Blackend7/Masterproef_2021_2022/Hardware design/Masterproef ultrasonic transducer/Masterproef ultrasonic transducer/Masterproef ultrasonic transducer top.jpg

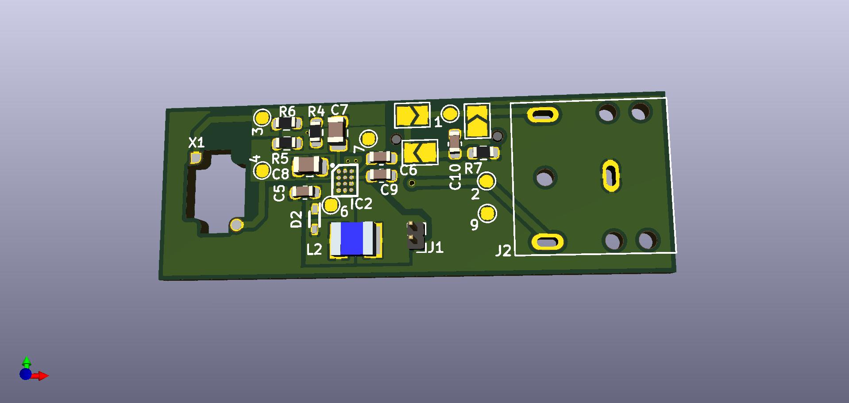
Hardware design/Masterproef ultrasonic transducer/Masterproef ultrasonic transducer/Masterproef ultrasonic transducer top.jpg
