Blackend7/Masterproef_2021_2022/Hardware design/MAsterproef verbeterd ultrasone speaker/Masterproef ultrasonic transducer.html

# C:\Users\robin\OneDrive\Masterproef 2021-2022\Hardware design\Masterproef ultrasonic transducer\Masterproef ultrasonic transducer\Masterproef ultrasonic transducer.sch

30/09/2021 14:57:56

Eeschema (5.1.10)-1

Component Count:35

Ref | Qnty | Value | Part | Footprint | Description | Vendor
C1, C4, C5, C6, C9 | 5 | 1µF | pspice:CAP | Capacitor_SMD:C_0603_1608Metric | Capacitor symbol for simulation only
C2 | 1 | 2,2µF | pspice:CAP | Capacitor_SMD:C_0603_1608Metric | Capacitor symbol for simulation only
C3, C7, C8 | 3 | 10µF | pspice:CAP | Capacitor_SMD:C_0805_2012Metric | Capacitor symbol for simulation only
D1 | 1 | NSR0520V2T1G | Masterproef-ultrasonic-transmitter-rescue:NSR0520V2T1G-SamacSys_Parts | SamacSys_Parts 2:SODFL1608X70N
IC1 | 1 | TPS61046YFFR | Masterproef-ultrasonic-transmitter-rescue:TPS61046YFFR-SamacSys_Parts | SamacSys_Parts:BGA6C40P2X3_79X119X62
IC2 | 1 | LM48580TL_NOPB | Masterproef-ultrasonic-transmitter-rescue:LM48580TL_NOPB-SamacSys_Parts | SamacSys_Parts:BGA12C50P3X4_146X196X68
J1 | 1 | Power connector | Connector_Generic:Conn_02x03_Odd_Even | Connector_PinHeader_1.00mm:PinHeader_2x03_P1.00mm_Vertical | Generic connector, double row, 02x03, odd/even pin numbering scheme (row 1 odd numbers, row 2 even numbers), script generated (kicad-library-utils/schlib/autogen/connector/)
J2 | 1 | Control | Connector:Conn_01x02_Male | Connector_PinHeader_1.00mm:PinHeader_1x02_P1.00mm_Vertical | Generic connector, single row, 01x02, script generated (kicad-library-utils/schlib/autogen/connector/)
J3 | 1 | Jack measure | Connector:Conn_01x03_Male | Connector_PinHeader_1.00mm:PinHeader_1x03_P1.00mm_Vertical | Generic connector, single row, 01x03, script generated (kicad-library-utils/schlib/autogen/connector/)
J4 | 1 | FC68131 | SamacSys_Parts_FC:FC68131 | FC68131_Farnell:CLIFF_FC68131
L1 | 1 | FDSD0420-H-100M=P3 | Masterproef-ultrasonic-transmitter-rescue:FDSD0420-H-100M=P3-SamacSys_Parts | SamacSys_Parts 2:FDSD0420WH150MP3
L2 | 1 | BRL3225T4R7M | Masterproef-ultrasonic-transmitter-rescue:BRL3225T4R7M-SamacSys_Parts | SamacSys_Parts 2:INDC3225X170N
R1 | 1 | 536k | pspice:R | Resistor_SMD:R_0603_1608Metric | Resistor symbol for simulation only
R2 | 1 | 30k | pspice:R | Resistor_SMD:R_0603_1608Metric | Resistor symbol for simulation only
R3, R4 | 2 | 100k | pspice:R | Resistor_SMD:R_0603_1608Metric | Resistor symbol for simulation only
R5 | 1 | 10 | pspice:R | Resistor_SMD:R_0603_1608Metric | Resistor symbol for simulation only
R6 | 1 | 1 | pspice:R | Resistor_SMD:R_0603_1608Metric | Resistor symbol for simulation only
X1 | 1 | Adap_UT_P2019 | Masterproef-ultrasonic-transmitter-rescue:Adap_UT_P2019-SamacSys_Parts | SamacSys_Parts:Adap_UT_P2019
