Blackend7/Masterproef_2021_2022/lectuur dramco/Lectuur/Overview of Ultrasonic or Combined Positioning Systems.docx

# Overview of Ultrasonic or Combined Positioning Systems

## Small band Ultrasonic

### The Cricket Indoor Location System (N. B. Priyantha, H. Balakrishnan)

There are two types of entities in the system:

- Beacons: they have a fixed position and send out periodically RF signals with an embedded ID code, temperature and coordinates. Together with this, an US signal is transmitted.

-Listeners: calculate their relative position based on the distances to the nearest beacons

Distance measurements are calculated by measuring the TDOA between RF and US.
The US signal is sent at the start of the RF message, and not at the start of the RF Signal.
Coverage is small: for a room size of 10x10x10m, 70 beacons are necessary

Cricket accuracy is around the 10cm for distances up to 6m.

The accuracy of the system heavily depends on:

- Line Of Sight
- The availability of the US signal: this is threshold based.
- Timing quantization, which is limited (1 µs)

### Error Compensation for Cricket Indoor Location System (S. Zhou, H. Feng, R. Yuan)

The accuracy of the cricket system is improved by compensating the error introduced by US fading. This is done both for the increasing distance, as well as the increasing orientation angle.
The average value of the absolute error is reduced to 5.6 cm and the standard deviation of the absolute error is reduced to 3.99cm.

### The research on Indoor Location System Based on Cricket (H. Wang, Y. Wang)

Badly written paper.
Use some kind of polling system to avoid collisions.

### Active Bat A. Harter, A. Hopper, P. Steggles, A. Ward, P. Webster

Consists of a wired receiver matrix mounted on the ceiling, which are connected to a PC.

Wireless transmitters have an unique ID and consist of a RF transceiver and an US transmitter
Positioning is done as followed: the RF base stations (receiver matrix) send out a RF signal on which the correct bat answers with a US pulse. The receivers then calculate the position of the bat.
It has 7cm accuracy, is strongly centralized and needs precisely positioned receiver nodes.

### Dolphin: A Practical Approach for Implementing a Fully Distributed Indoor Ultrasonic Positioning System M. Minami, Y. Fukuju, K. Hirasawa, S. Yokoyama, M. Mizumachi, H. Morikawa, T. Aoyama

The problem with Active Bat and Cricket is that they need a lot of reference nodes that are exactly positioned.

Dolphin system uses Iterative multilateration. Every node in iterative multilateration that can estimate its own position becomes a reference (anchor) node itself.

Valid distances are limited to 3m, limited to 50 nodes due to processing time and propagation speed US. Precision is limited to 10-20 cm.

### Hexamite www.hexamite.com

Claim an accuracy of 3mm.
No technical information available: what does it use? US + RF?

### Indoor Positioning using Ultrasonic Waves with CSS and FSK Modulation for Narrow Band Channel A. Ens, F. Hoeflinger, L. Reindl, J. Wendeberg and C. Schindelhauer

Make use of chirps for:

1) Synchronisation
2) Communication

This is done via Chirp Spread Spectrum and Frequency shift keying.

Chirp up or high frequency is 1, chirp down or lower frequency is 0.

No practical results.

### Ultrasonic Autonomous Robot Localization System. L. Kleeman

System in which the fixed nodes are known.

Uses chirps with a fixed duration.
The time difference between the incoming chirps give an indication of the distance between the different beacons.

### The BUZZ: Narrowband ultrasonic positioning for wearable computers. M. R. McCarthy

Positioning is done at the hand of patterns, with the timing information communicated from the infrastructure to the wearable device.
There is no RF signal, only a US.

There are two types of the buzz:

Synchronous: transmitters are synchronized throughout a cable

Asynchronous: like cricket, without the RF. Low accuracy.

The mobile needs to be at the specific place when started.

4cm accuracy @ 50% of the cases, 10cm @ 95% of the cases.

### Low-Power Simplex Ultrasound Communication For Indoor Localization A. Ens, L. Reindl, T. Janson, C. Schindelhauer.

## Ultrasonic TDOA technique that uses Pi/4 DQPSK (this uses a PI/4 phase transmission between 2 recursive signals). Distance up to 20m, with a theoretical error of 3,7 µm.

TDOA is generated thanks to a fixed interval between two recursive signals. Different transmitters have different intervals.
They don’t care about collisions and use LOS only.

The PI/4 is generated throughout tables in the microcontroller.
Localization is calculated on a different server.

### A battery-free RFID-based indoor acoustic localization platform Y. Zhao, J.R. Smith

Uses a combination of RF and US to localize a passive tag. It consist of 3 parts: programmable UHF tags (WISP) for the receiver (Rx) and transmitting end (Tx), and an off-the-shelf RFID reader.

Distance measurements:

1. RFID reader sends out Query’s to detect possible Rx. The Rx answers with a 16-bit know number (RN16: which is normally random). Normally, every tag answers, but the Tx tags are configured to only monitor the nearby RF field.
2. RFID reader answers with an ACK and the RN16 number.
3. Rx will send its own EPC code (unique ID).
4. Upon reception of the ACK and after finishing the Rx’s EPC transmission, the receiver starts a timer and the transmitters send out a US signal, this with fixed interval between two US signals coming from different Tx.
5. The ToA of the received US signals are stored on the Rx and the next round they are backscattered to the RFID reader.
6. At the RFID-reader: the location is calculated with trilateration.

Distances are limited to 3m due to detection timeouts coming from energy constraints.
Accuracy is 0 to 1.5cm within the testing range of 0.6 to 2.2m.

Transmitters are placed on known positions.

Power usage: the Rx only uses 82 µW which is harvested from RF-energy.

### Ultrasound Indoor Positioning system Based on Low-Power Wireless Sensor Network Providing Sub-Centimeter Accuracy C. Medina, J. C. Segura, A. De La Torre

This paper describes the TELIAMADe system.

This system uses a master-slave topology in which the master node is connected to a PC to do the calculations (acts as a gateway). The communication, synchronization, configuration and control between the master and the slaves is done throughout Zigbee. Time synchronisation is done with periodic Zigbee messages.

Nodes are equipped with a pair of ceramic US piezotransducers (1 for Tx, 1 for Rx) Synchronisation in the ultrasonic channel is done by using TDMA.

TOF measurements are returned over Zigbee.

Power consumption is 29.9 mA in active mode, 1,7 mA in inactive mode.

To improve distance measurements, quadrature sampling is used.

Root Mean Square Error is lower than 2mm

## Broadband Ultrasonic

### Why?

Smallband US:

- single user access
- Slower data rate
- Noise Sensitive

### Broadband US Location Systems for Improved Indoor Position (M. Hazas, A. Hopper)

Made their own piezofilm transceiver: improved BW (76 kHz, 2,5m distance).
Used DSSS (Direct Sequence Spread Spectrum) which uses pseudo random codes to spread out the signal over the spectrum. (Gold codes in this case)
CDMA: Code Division Multiple Access: preventing the overlap of signals that are coming from different users.
They give mm accuracy for distances up to 2,5m.
No information about the power usage.
To improve signal detection and prevent interference between different users in the CDMA they make use of SIC (Successive Interference Cancellation).

### High Precision OFDM-based multiple Ultrasonic transducers (O. Khyam, J. Alam, A. J. Lambert, M. A. Garratt, M. P. Pickering)

Overview of different US positioning systems.
Uses OFDM (Orthogonal Frequency Division Multiplexing) in which the available US spectrum is divided into several, small band channels (sub carriers).
Sub mm accuracy in a small 3D environment (20x20x20 mm)

### Opto-Acoustic Distance Measurement Using Spread Spectrum Techniques and Carrier Phase Measurements P. Rapp, O. Sawodny, C. Tarin.

Uses Ultrasonic and Infrared to determine distances. With a fixed receiver and a mobile transmitter.
This is done via 2 techniques:

- Envelope Time of Flight (cm accuracy). This uses Gold Codes to define the ID of the transmitter. This enable CDMA. The distances are calculated via a convolution between the Received IR and Received Ultrasonic signal.
- Carrier Phase mode: (mm accuracy) which uses zero-crossing to know the phase difference between the received US and IR signal.

### Ultrasonic Multiple-Access Ranging System Using Spread Spectrum and MEMS Technology for Indoor Localization L. Segers, J. Tiete, A. Braeken, A. Touhafi.

Spread Spectrum via:

- DSSS and gold codes. The spreading is done throughout Binary Phase Shift Keying around 40k.
- FHSS: frequency hopping spread spectrum. In which gold codes are used by switching between 4 frequencies.

Distance measurements have sub-cm accuracy with 1 node and 5 cm when 2 nodes are transmitting at the same time.

Synchronisation is done with a fixed link between sender and receiver.

### High-Accuracy Reference-Free Ultrasonic Location Estimation M. M. Saad, C. J. Bleakley, T. Ballal, S. Dobson

Reference free = no timing reference signal is used (RF, IR, …)
Beacons send out a unique FHSS (Frequency Hopping Spread Spectrum) signal with Gold, m-sequence, Kasami or Golay code as a hopping sequence SS code.
Beacons are completely independent and share no timing reference information.

Receiver must consist of at least 3 microphones in a triangle.

The algorithm utilizes an AoA-based location method to obtain an initial estimate of its own location. Based on this, it estimates the timing offsets between the MD clock and the beacon transmission. The average and the known periodicities of the beacon signals are then used to obtain a second more accurate MD location estimate via TOF.

9.5 cm accuracy in 99% cases.

### Highly Accurate TOF Measurement Technique Based on Phase-Correlation for Ultrasonic Ranging O. Khyam, S. S. Ge, X. Li, M. R. Pickering

Improved cross correlation technique is proposed for signals with the same bandwidth.
This technique uses phase correlation instead of cross correlation in time which results in a much smaller correlation peak and thus a more accurate measurements.

Precision is 0,1 till 9.17mm

A system model for linear chirp is introduced.

### Subcentimeter-Accuracy Localization through broadband acoustic transducers. J. C. Prieto, A. R. Jimenez, J. I. Guevara, J. L. Ealo, F. A. Seco, J. O. Roa, F. X. Ramos

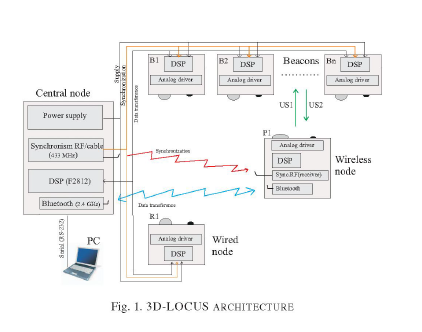
[picture p3: figure]

3D-LOCUS homogeneous network of wired and wireless sensor nodes governed by a central node. PC connected to the central node is used for high-level data processing and analysis.

Wired connections are done via a BusCAN network for data and a LVDS bus for synchronization.
Wireless connections are done with Bluetooth for data and a standard 433 MHz radio link for synchronisation.

Wideband acoustic transmitters with BW from 5kHz to 25 kHz.

Golay codes are used for cross correlation because of their more efficient computation than standard FFT’s.

2.8x2.8m cell with robotic arm to move the node. In ideal conditions the accuracy was 0.22mm.
