Blackend7/Masterproef_2021_2022/Bronnen - literatuur studie/Gebruikte lectuur/bronnen voor wifi.docx

### Wireless Indoor Localization: A Crowdsourcing Approach by Chenshu Wu, Zheng Yang, Yunhao Liu. (https://limo.libis.be/primo-explore/fulldisplay?docid=32LIBIS_ALMA_DS71222208870001471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)

Wu, Chenshu.; Wu, Chenshu. [author] () ; Yang, Zheng. [author.] ; Liu, Yunhao.

Singapore : Springer Singapore : Imprint Springer, 2018.

https://limo.libis.be/primo-explore/fulldisplay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,contains,Wifi,AND&query=title,contains,%22indoor%20localization%22,AND&mode=advanced&offset=0

(https://limo.libis.be/primo-explore/fulldisplay?docid=TN_cdi_webofscience_primary_000448661500265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)

Artikel

### A High Accuracy Time-Reversal Based WiFi Indoor Localization Approach with a Single Antenna (https://limo.libis.be/primo-explore/fulldisplay?docid=TN_cdi_webofscience_primary_000448661500265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)

Zheng, Lili ; Hu, Binjie ; Chen, Haoxiang

BASEL: MDPI

Sensors (Basel, Switzerland), 2018-10-12, Vol.18 (10), p.3437

https://limo.libis.be/primo-explore/fulldisplay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,contains,Wifi,AND&query=title,contains,%22indoor%20localization%22,AND&query=title,contains,Time,AND&mode=advanced&offset=0

Conferentieverslag

### An Accurate AoA Estimation Approach for Indoor Localization Using Commodity Wi-Fi Devices (https://limo.libis.be/primo-explore/fulldisplay?docid=TN_cdi_ieee_primary_8567806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)

Chen, Hao-Xiang ; Hu, Bin-Jie ; Zheng, Li-Li ; Wei, Zong-Heng

IEEE

2018 IEEE International Conference on Signal Processing, Communications and Computing (ICSPCC), 2018-09, p.1-5

https://limo.libis.be/primo-explore/fulldisplay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,contains,Wifi,AND&query=title,contains,%22indoor%20localization%22,AND&query=title,contains,AOA,AND&mode=advanced&offset=0

Due to the ubiquity of Wi-Fi infrastructure, Wi-Fi-based

indoor localization technology is the mainstream solution to

the above problem in academic. At present, most of the Wi-

Fi-based solutions are using fingerprinting approaches [2-5],

which will be easy to implemented. When the fingerprint

database is constructed in off-line stage, they can achieve

meter-level localization accuracy in on-line stage. As is

known to all, the disadvantage of fingerprinting-based

approaches is that the fingerprint database construction takes

a lot of time and resources. Moreover, when the environment

changes, we need to reconstruct the fingerprint database,

otherwise the performance of localization will be deteriorated

significantly.

Comparing with fingerprinting-based approaches, Angleof-

Arrival (AoA) based approaches have attracted widely

attention due to their zero start-up costs. Recently, multiantenna

has been deployed in the commodity Wi-Fi

infrastructure, which allows us to perform AoA-based indoor

localization approaches via Wi-Fi.
