Blackend7/Masterproef_2021_2022/Deeltaken/varia/Binnenshuis lokalisatie tussentijdse planning.docx

# Binnenshuis lokalisatie

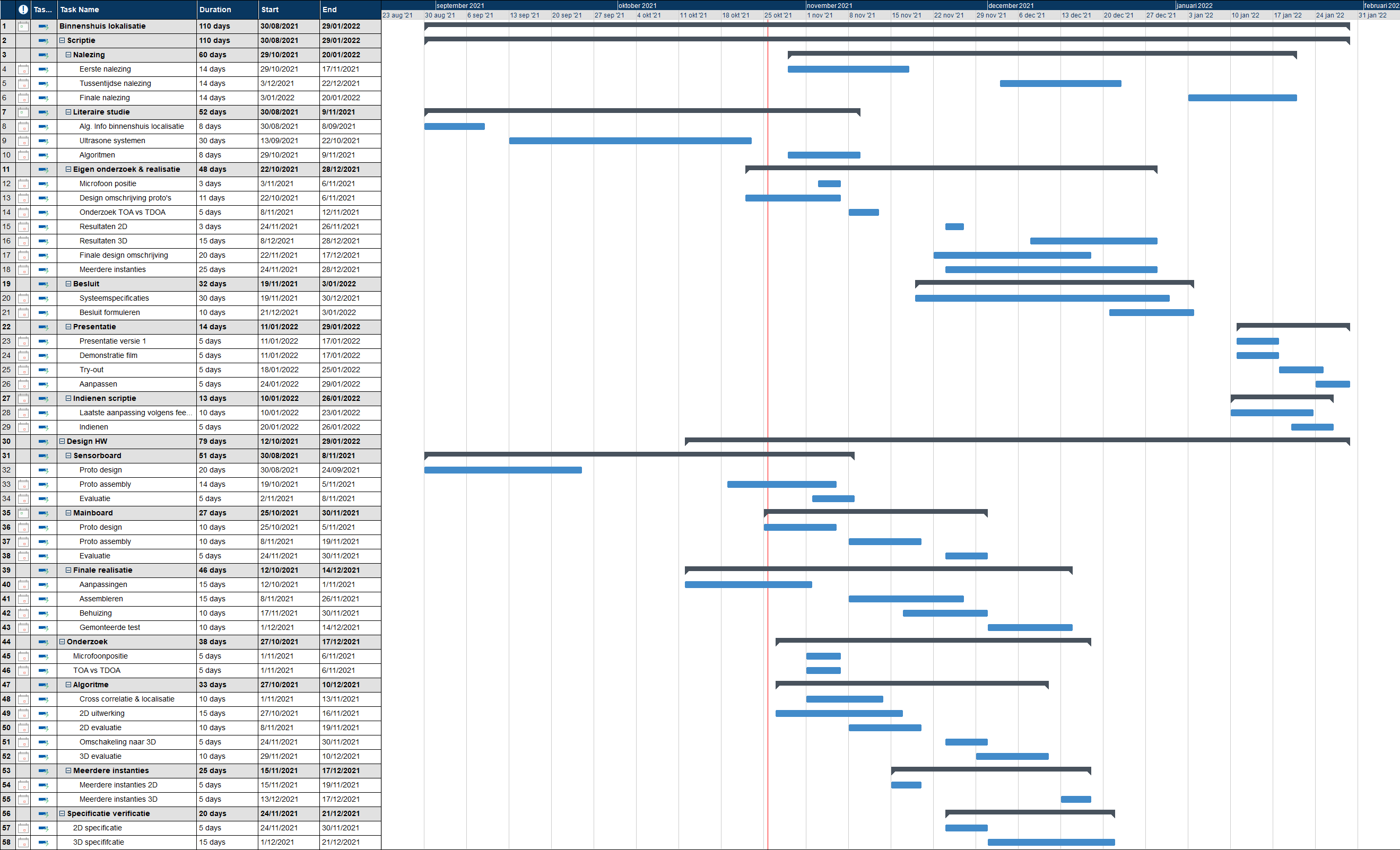
[picture p4: figure]
MindMap Preview

# 1 Scriptie

## 1.1 Nalezing

### Eerste nalezing

### Tussentijdse nalezing

### Finale nalezing

## 1.2 Literaire studie

### Alg. Info binnenshuis localisatie

### Ultrasone systemen

### Algoritmen

## 1.3 Eigen onderzoek & realisatie

### Microfoon positie

### Design omschrijving proto's

### Onderzoek TOA vs TDOA

### Resultaten 2D

### Resultaten 3D

### Finale design omschrijving

### Meerdere instanties

## 1.4 Besluit

### Systeemspecificaties

### Besluit formuleren

## 1.5 Presentatie

### Presentatie versie 1

### Demonstratie film

### Try-out

### Aanpassen

## 1.6 Indienen scriptie

### Laatste aanpassing volgens feedback

### Indienen

# 2 Design HW

## 2.1 Sensorboard

### Proto design

### Proto assembly

### Evaluatie

## 2.2 Mainboard

### Proto design

### Proto assembly

### Evaluatie

## 2.3 Finale realisatie

### Aanpassingen

### Assembleren

### Behuizing

### Gemonteerde test

# 3 Onderzoek

## 3.1 Microfoonpositie

## 3.2 TOA vs TDOA

## 3.3 Algoritme

### Cross correlatie & localisatie

### 2D uitwerking

### 2D evaluatie

### Omschakeling naar 3D

### 3D evaluatie

## 3.4 Meerdere instanties

### Meerdere instanties 2D

### Meerdere instanties 3D

# 4 Specificatie verificatie

## 4.1 2D specificatie

## 4.2 3D specififcatie

[Title] | February 17, 2015
