Blackend7/Masterproef_2021_2022/Hardware design/Masterproef ultrasonic transducer/BOM ultrasonic transducer Robin Van de Poel met supplier.xlsx

 |  |  | Digi-key | Farnell
Component Count: | 25
Ref | Value | Footprint
C1 | 1µF | Capacitor_SMD:C_0603_1608Metric | https://www.digikey.be/product-detail/en/taiyo-yuden/TMK107BJ105KA8T/587-TMK107BJ105KA8TTR-ND/14311221
C2 | 2,2µF | Capacitor_SMD:C_0603_1608Metric | https://www.digikey.be/product-detail/en/taiyo-yuden/TMK107ABJ225KA-T/587-2909-1-ND/2649029
C3 | 10µF | Capacitor_SMD:C_0805_2012Metric | https://www.digikey.be/product-detail/en/taiyo-yuden/LMK212BJ106KD-T/587-1299-1-ND/931076
C4 | 1µF | Capacitor_SMD:C_0603_1608Metric | https://www.digikey.be/product-detail/en/taiyo-yuden/TMK107BJ105KA8T/587-TMK107BJ105KA8TTR-ND/14311221
C5 | 1µF | Capacitor_SMD:C_0603_1608Metric | https://www.digikey.be/product-detail/en/taiyo-yuden/TMK107BJ105KA8T/587-TMK107BJ105KA8TTR-ND/14311221
C6 | 1µF | Capacitor_SMD:C_0603_1608Metric | https://www.digikey.be/product-detail/en/taiyo-yuden/TMK107BJ105KA8T/587-TMK107BJ105KA8TTR-ND/14311221
C7 | 10µF | Capacitor_SMD:C_0805_2012Metric | https://www.digikey.be/product-detail/en/samsung-electro-mechanics/CL21A106KAYNNNG/1276-6454-1-ND/5958082
C8 | 10µF | Capacitor_SMD:C_0805_2012Metric | https://www.digikey.be/product-detail/en/samsung-electro-mechanics/CL21A106KAYNNNG/1276-6454-1-ND/5958082
C9 | 1µF | Capacitor_SMD:C_0603_1608Metric | https://www.digikey.be/product-detail/en/taiyo-yuden/TMK107BJ105KA8T/587-TMK107BJ105KA8TTR-ND/14311221
D1 | NSR0520V2T1G | SamacSys_Parts 2:SODFL1608X70N
IC1 | TPS61046YFFR | SamacSys_Parts:BGA6C40P2X3_79X119X62
IC2 | LM48580TL_NOPB | SamacSys_Parts:BGA12C50P3X4_146X196X68 | https://www.digikey.be/product-detail/en/texas-instruments/LM48580TLX-NOPB/LM48580TLX-NOPBCT-ND/2346535
J1 | Power connector | Connector_PinHeader_1.00mm:PinHeader_2x03_P1.00mm_Vertical
J2 | Control | Connector_PinHeader_1.00mm:PinHeader_1x02_P1.00mm_Vertical
J3 | Jack measure | Connector_PinHeader_1.00mm:PinHeader_1x03_P1.00mm_Vertical
J4 | FC68131 | FC68131_Farnell:CLIFF_FC68131 |  | https://be.farnell.com/cliff-electronic-components/fc68131/stereo-jack-3-5mm-3pos-pcb/dp/2518188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
L1 | FDSD0420-H-100M=P3 | SamacSys_Parts 2:FDSD0420WH150MP3 |  | https://be.farnell.com/murata/fdsd0420-h-100m-p3/inductor-10uh-2a-20-shielded/dp/2530093?CMP=GRHB-SF-BNL
L2 | BRL3225T4R7M | SamacSys_Parts 2:INDC3225X170N | https://www.digikey.be/product-detail/en/taiyo-yuden/BRL3225T4R7M/587-2166-1-ND/2002864 | https://be.farnell.com/taiyo-yuden/brl3225t4r7m/wirewound-inductor-4-7uh-1-3a/dp/1839395?st=brl3225t4r7m
R1 | 536k | Resistor_SMD:R_0603_1608Metric | https://www.digikey.be/product-detail/en/stackpole-electronics-inc/RMCF0603FT536K/RMCF0603FT536KCT-ND/2418087
R2 | 30k | Resistor_SMD:R_0603_1608Metric | https://www.digikey.be/product-detail/en/panasonic-electronic-components/ERJ-PB3B3002V/P20138CT-ND/6214393
R3 | 100k | Resistor_SMD:R_0603_1608Metric | https://www.digikey.be/product-detail/en/panasonic-electronic-components/ERA-3ARB104V/P100KBDCT-ND/3073246
R4 | 100k | Resistor_SMD:R_0603_1608Metric | https://www.digikey.be/product-detail/en/panasonic-electronic-components/ERA-3ARB104V/P100KBDCT-ND/3073246
R5 | 10 | Resistor_SMD:R_0603_1608Metric | https://www.digikey.be/product-detail/en/stackpole-electronics-inc/RNCF0603AKT10R0/RNCF0603AKT10R0CT-ND/4928393
R6 | 1 | Resistor_SMD:R_0603_1608Metric | https://www.digikey.be/product-detail/en/panasonic-electronic-components/ERJ-3RQF1R0V/P1-0AJCT-ND/308110
X1 | Adap_UT_P2019 | SamacSys_Parts:Adap_UT_P2019 | https://www.digikey.be/product-detail/en/usound-gmbh/UT-P2019/2000-UT-P2019-ND/12658981
