Blackend7/Masterproef_2021_2022/Hardware design/BRL3225T4R7M/3D/BRL3225T4R7M.stp

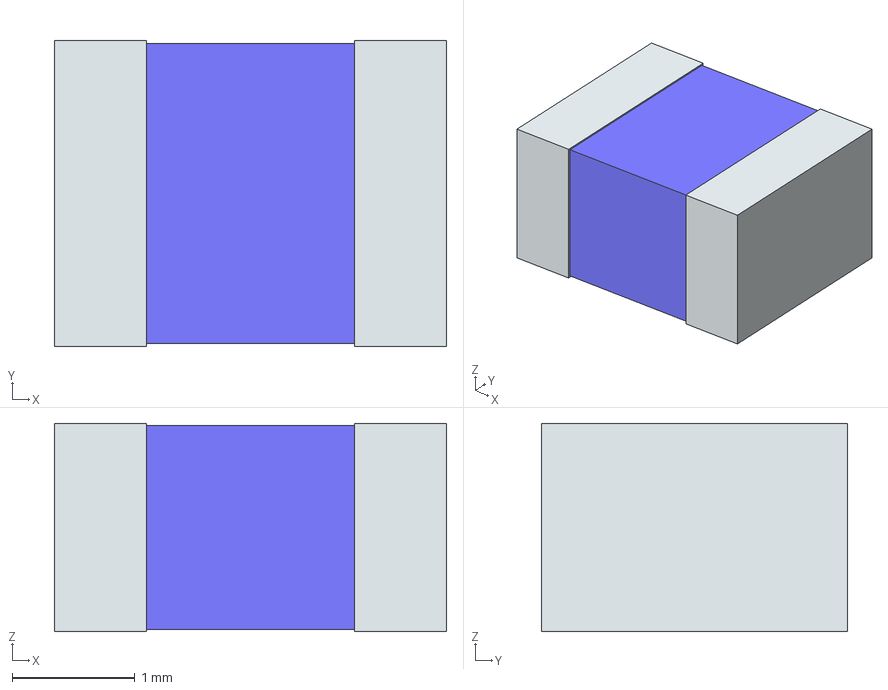
[picture p16: CAD file, 2022-01-28]
Hardware design/BRL3225T4R7M/3D/BRL3225T4R7M.stp
3.20 x 2.50 x 1.70 mm
term1
term2
