Blackend7/Masterproef_2021_2022/Hardware design/FDSD0420-H-100M=P3/3D/FDSD0420-H-100M=P3.stp

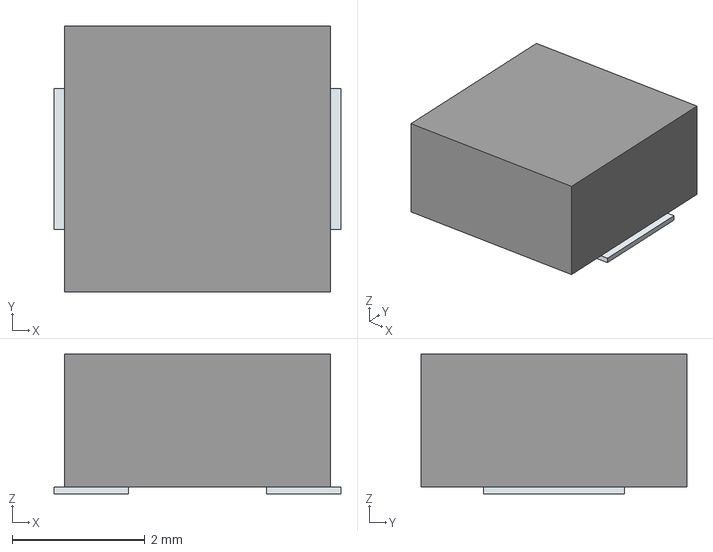
[picture p17: CAD file, 2022-01-28]
Hardware design/FDSD0420-H-100M=P3/3D/FDSD0420-H-100M=P3.stp
4.32 x 4.00 x 2.10 mm
Pins
