Blackend7/Masterproef_2021_2022/Hardware design/NSR0520V2T1G/3D/NSR0520V2T1G.stp

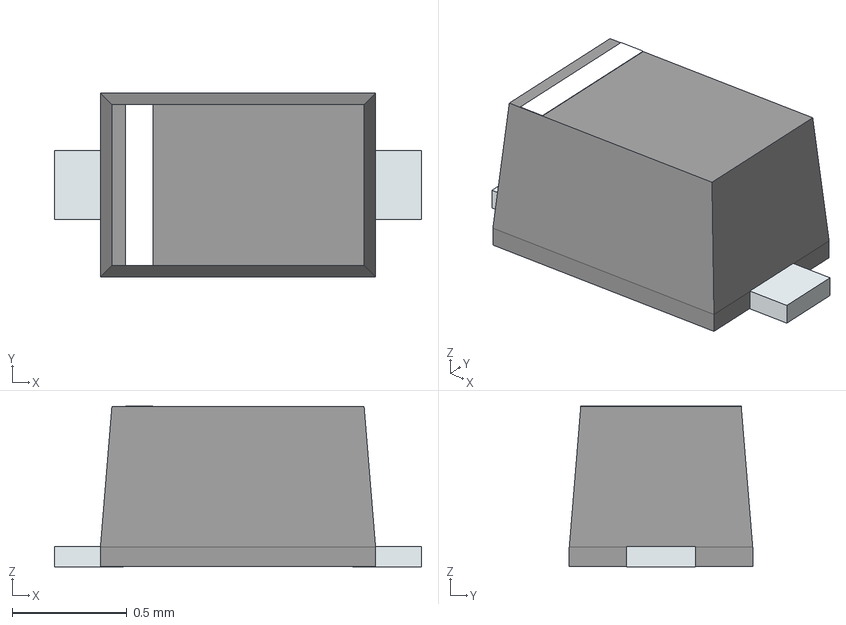
[picture p18: CAD file, 2022-01-28]
Hardware design/NSR0520V2T1G/3D/NSR0520V2T1G.stp
1.60 x 0.8 x 0.7 mm
PinKIdent
PinK
PinA
