Blackend7/Masterproef_2021_2022/Hardware design/FC68131/FC68131/FC68131.step

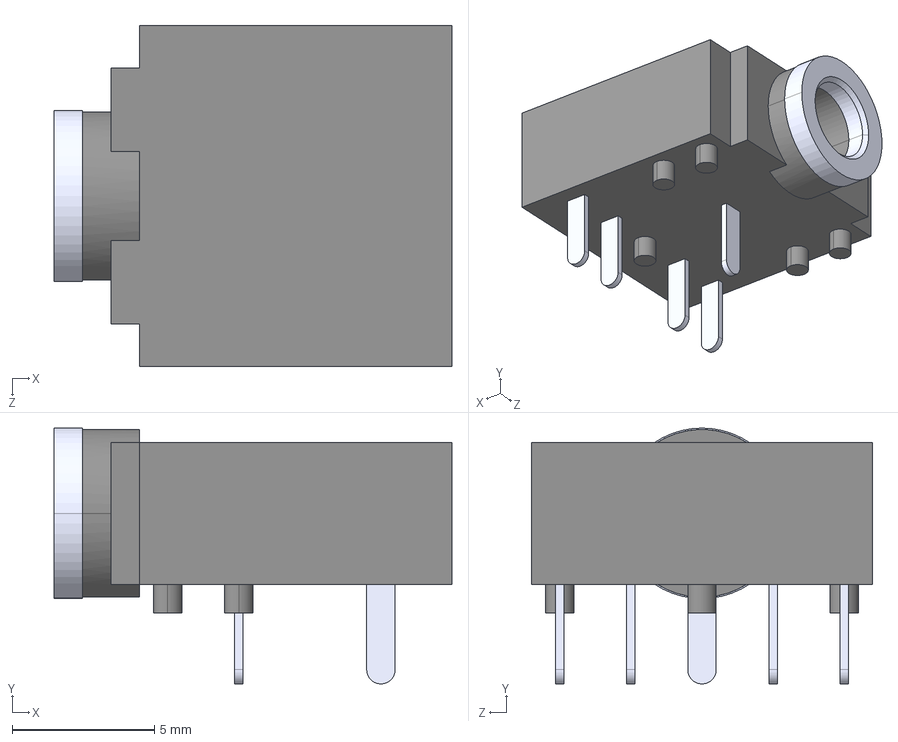
[picture p19: CAD file, 2022-01-28]
Hardware design/FC68131/FC68131/FC68131.step
14.0 x 9.00 x 12.0 mm
