Blackend7/Masterproef_2021_2022/(list of files, cad)

Other CAD files:
Hardware design/BRL3225T4R7M/3D/BRL3225T4R7M.stl
Hardware design/BRL3225T4R7M/Allegro/indc3225x170n.psm
Hardware design/BRL3225T4R7M/DEHDL/brl3225t4r7m/chips/chips.prt
Hardware design/FDSD0420-H-100M=P3/3D/FDSD0420-H-100M=P3.stl
Hardware design/FDSD0420-H-100M=P3/Allegro/fdsd0420wh150mp3.psm
Hardware design/FDSD0420-H-100M=P3/DEHDL/fdsd0420_h_100m=p3/chips/chips.prt
Hardware design/NSR0520V2T1G/3D/NSR0520V2T1G.stl
Hardware design/NSR0520V2T1G/Allegro/sodfl1608x70n.psm
Hardware design/NSR0520V2T1G/DEHDL/nsr0520v2t1g/chips/chips.prt
Hardware design/PMEG2010AEB,115/Allegro/sod1608x65n.psm
Hardware design/PMEG2010AEB,115/DEHDL/pmeg2010aeb_115/chips/chips.prt
