Blackend7/Masterproef_2021_2022/Experimenten - metingen/Metingen ultrasone bordje proto.xlsx

Sheet: Signaalniveau meting
Metingen ultrasone bordje proto
Signaalniveau
V_in_amp (Vpp) | gain | V_out_amp (Vpp) | f = 9,78kHZ | V_in | f (kHZ) | VCC | Voutp_p
1.5 | float (18dB) | 9.7 |  | 1.13 | 5 | 3 | 24,,4
1.75 | float (18dB) | 11.2 |  | 1.13 | 10 | 3 | 22.4
2 | float (18dB) | 13.1 |  | 1.13 | 15 | 3 | 19.1
2.25 | float (18dB) | 14.9 |  | 1.13 | 20 | 3 | 15.1
2.5 | float (18dB) | 15.4 | vervorming zie verschillende foto's | 1.13 | 25 | 3 | 11.9
2.75 | float (18dB) | 18.1 |  | 1.13 | 30 | 3 | 9.5
3 | float (18dB) | 19.9
3.25 | float (18dB) | 21.1
3.5 | float (18dB) | 22.6 |  | 1.13 | 5 | 3.3 | 24.5
 | Versterking klopt gain pin niet goed gesoldeerd. |  |  | 1.13 | 10 | 3.3 | 23.2
 |  |  |  | 1.13 | 15 | 3.3 | 20
 |  |  | f = 30kHZ | 1.13 | 20 | 3.3 | 16
1.5 | float (18dB) | 9.7 | tweede foto | 1.13 | 25 | 3.3 | 13
2.25 | float (18dB) | 10.1 | eerste foto | 1.13 | 30 | 3.3 | 10.35
3 | float (18dB) | 10.1 | derde foto
 |  |  | f = 20kHZ | 1.13 | 5 | 3.6 | 24.6
1.5 | float (18dB) | 9.8 | eerste foto | 1.13 | 10 | 3.6 | 23.5
2.25 | float (18dB) | 13.8 | tweede foto | 1.13 | 15 | 3.6 | 21.3
3 | float (18dB) | 15.4 | derde foto | 1.13 | 20 | 3.6 | 16.7
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
