Blackend7/Masterproef_2021_2022/Experimenten - metingen/meting daq smaller view/meting 250(2).png

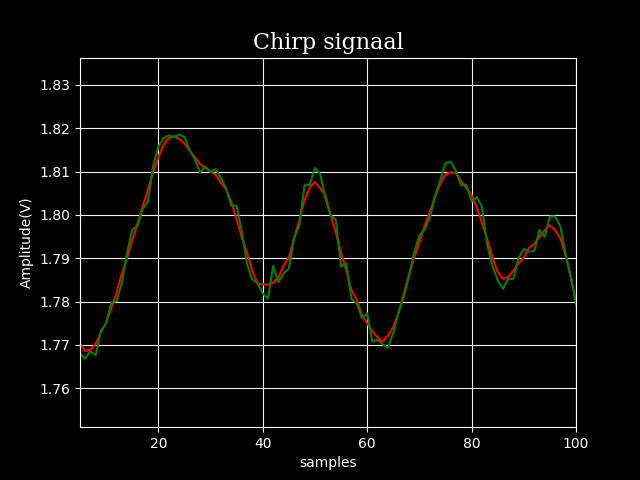
Experimenten - metingen/meting daq smaller view/meting 250(2).png
