Blackend7/Masterproef_2021_2022/Experimenten - metingen/simulaties/Session 2/Some simulations next to each other.png

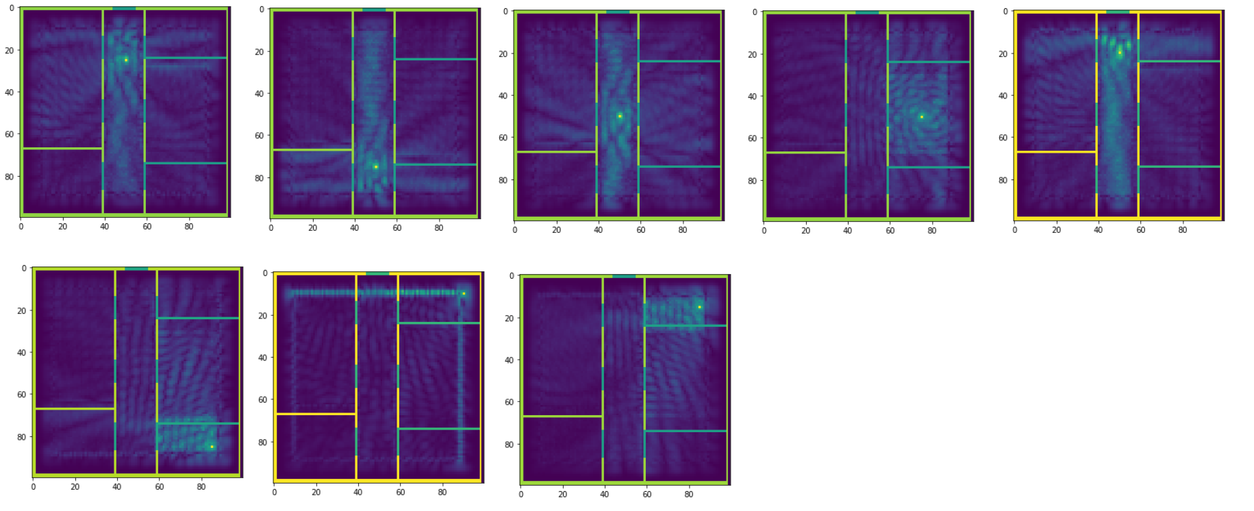
Experimenten - metingen/simulaties/Session 2/Some simulations next to each other.png
