Blackend7/Masterproef_2021_2022/Hardware design/Masterproef ultrasonic transducer/prod proto alternatief/Masterproef ultrasonic transducer-B_Cu.pdf

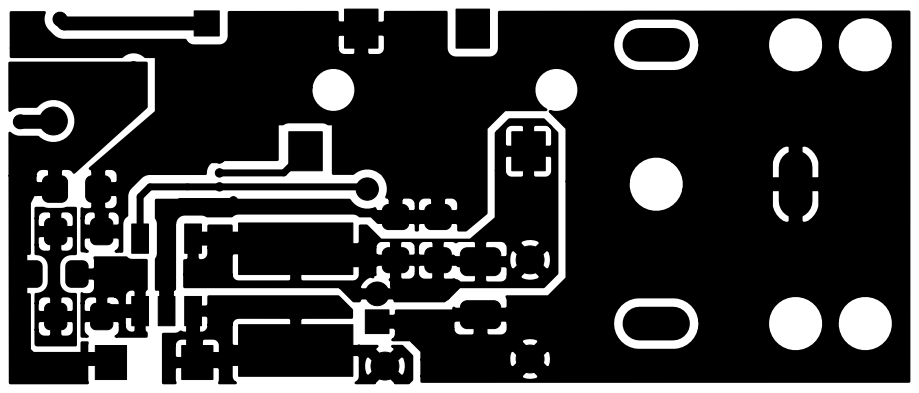
[picture p28: page 1]
