Blackend7/Masterproef_2021_2022/Hardware design/Masterproef ultrasonic transducer/prod proto alternatief/Masterproef ultrasonic transducer-B_Mask.pdf

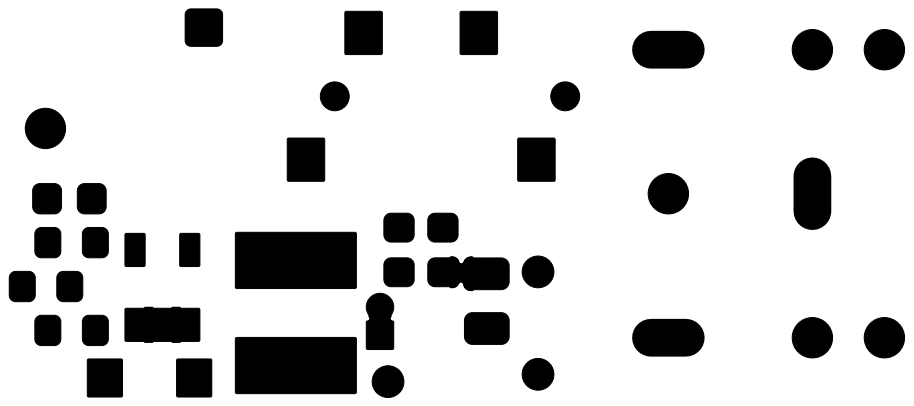
[picture p29: page 1]
