Blackend7/Masterproef_2021_2022/Hardware design/Masterproef ultrasonic transducer/prod proto alternatief/Masterproef ultrasonic transducer-B_Paste.pdf

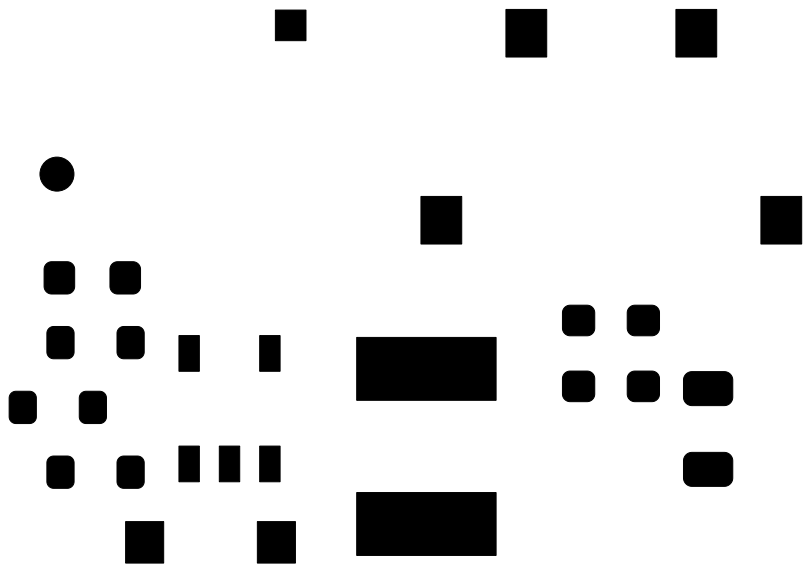
[picture p30: page 1]
