Blackend7/Masterproef_2021_2022/Hardware design/Masterproef ultrasonic transducer/prod proto alternatief/Masterproef ultrasonic transducer-B_SilkS.pdf

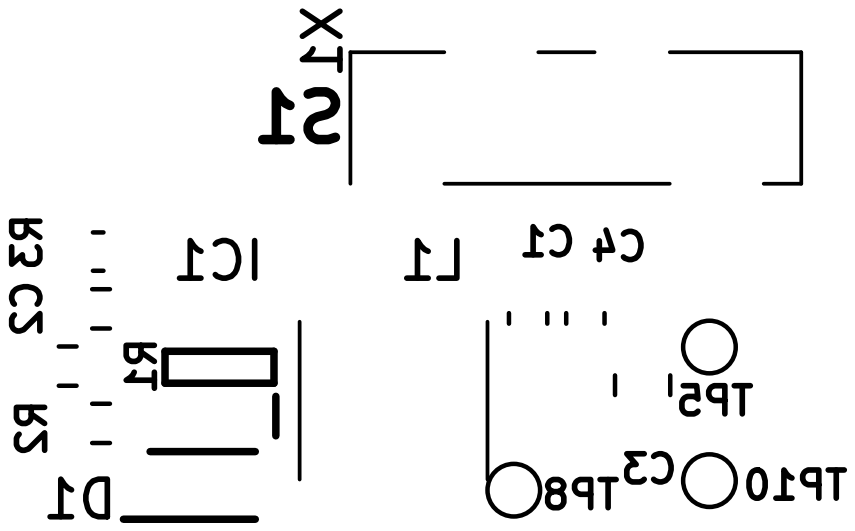
[picture p31: page 1]
