Blackend7/Masterproef_2021_2022/Hardware design/Masterproef ultrasonic transducer/prod proto alternatief/Masterproef ultrasonic transducer-Dwgs_User.pdf

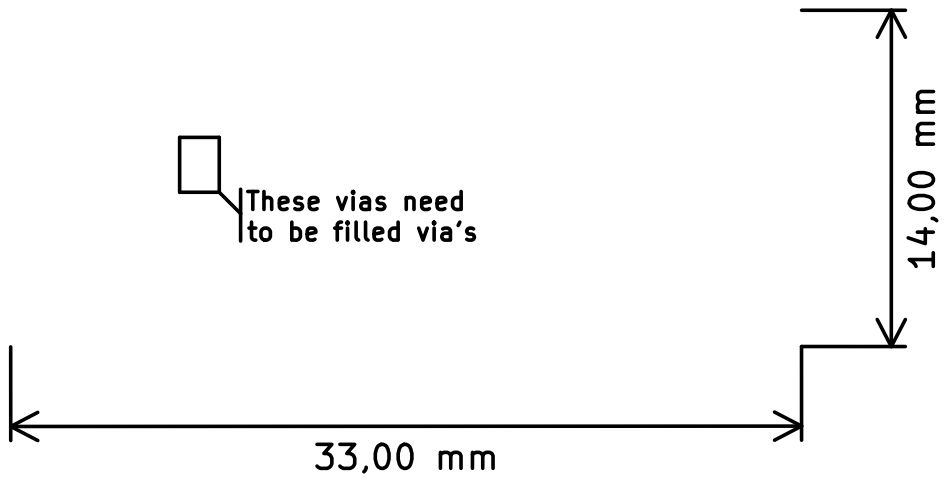
[picture p32: page 1]
