Blackend7/Masterproef_2021_2022/(list of files, drawings)

Other design files:
Hardware design/Masterproef ultrasonic transducer/prod proto alternatief/Masterproef ultrasonic transducer.dsn
Hardware design/Masterproef ultrasonic transmitter/Masterproef ultrasonic transmitter.dsn
