Blackend7/Masterproef_2021_2022/Hardware design/Masterproef ultrasonic transmitter/Masterproef ultrasonic transmitter.kicad_pcb

## KiCad design Hardware design/Masterproef ultrasonic transmitter/Masterproef ultrasonic transmitter.kicad_pcb (2022-01-28)

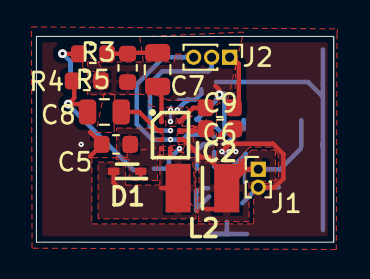
[picture p37: board Masterproef ultrasonic transmitter.kicad_pcb from above]

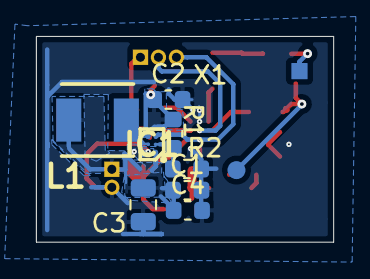
[picture p38: board Masterproef ultrasonic transmitter.kicad_pcb from below]

Board: 2 copper layers, 16.5 x 11.4 mm, 22 parts (9 on the bottom side), 17 nets.

Parts:
C1, C4, C5, C6, C9: 1µF; C_0603_1608Metric
C2: 2,2µF; C_0603_1608Metric
C3, C7, C8: 10µF; C_0805_2012Metric
D1: NSR0520V2T1G; SODFL1608X70N
IC1: TPS61046YFFR; BGA6C40P2X3_79X119X62
IC2: LM48580TL_NOPB; BGA12C50P3X4_146X196X68
J1: Power; PinHeader_1x02_P1.00mm_Vertical
J2: Control; PinHeader_1x03_P1.00mm_Vertical
L1: FDSD0420-H-100M=P3; FDSD0420WH150MP3
L2: BRL3225T4R7M; INDC3225X170N
R1: 536k; R_0603_1608Metric
R2: 30k; R_0603_1608Metric
R3, R4: 100k; R_0603_1608Metric
R5: 10; R_0603_1608Metric
X1: Adap_UT_P2019

Connections:
+3V3: C1.1, C3.1, C4.1, IC1.A1, IC2.C3, J1.1, L1.1, L2.2
+15V: C2.1, IC1.C2, R1.1, R3.2, R4.2
/AUDIO_IN: C6.1, J2.1
/ENABLE: IC1.C1, IC2.C2, J2.3
/GAIN: IC2.B2, J2.2
/MEMS_NEG_POLE: C8.1, R4.1, X1.2
/MEMS_POS_POLE: R5.2, X1.1
GND: C1.2, C2.2, C3.2, C4.2, C5.2, C9.2, IC1.A2, IC2.A2, IC2.D3, J1.2, R2.2
unnamed: C5.1, D1.1, IC2.C1, IC2.D1
unnamed: C6.2, IC2.A3
unnamed: C7.1, R3.1, R5.1
unnamed: C7.2, IC2.A1
unnamed: C8.2, IC2.B1
unnamed: C9.1, IC2.B3
unnamed: D1.2, IC2.D2, L2.1
unnamed: IC1.B1, R1.2, R2.1
unnamed: IC1.B2, L1.2
