Blackend7/Masterproef_2021_2022/Hardware design/MAsterproef verbeterd ultrasone speaker/Masterproef ultrasonic transducer.kicad_pcb

## KiCad design Hardware design/MAsterproef verbeterd ultrasone speaker/Masterproef ultrasonic transducer.kicad_pcb (2022-01-28)

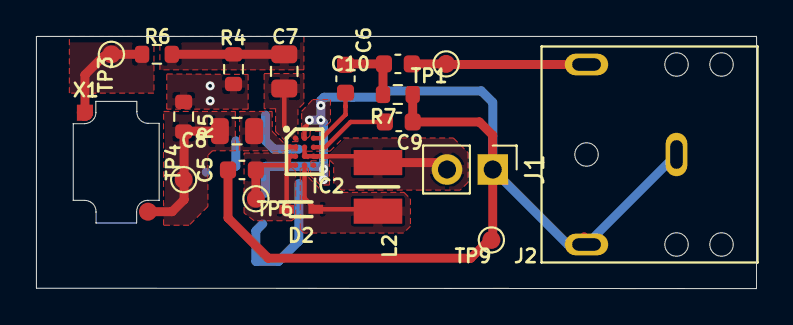
[picture p39: board Masterproef ultrasonic transducer.kicad_pcb from above]

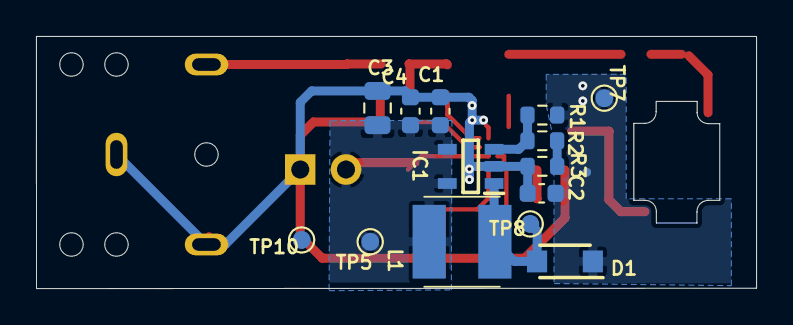
[picture p40: board Masterproef ultrasonic transducer.kicad_pcb from below]

Board: 2 copper layers, 40.0 x 14.0 mm, 35 parts (14 on the bottom side), 17 nets.

Parts:
C1: 10µF; C_0603_1608Metric
C2, C10: 2,2µF; C_0603_1608Metric
C3: 10µF; C_0805_2012Metric
C4, C5, C6, C9: 1µF; C_0603_1608Metric
C7, C8: 1µF; C_0805_2012Metric
D1: SS22FA; SODFL3618X143N
D2: PMEG2010AEB,115; SOD1608X65N
IC1: MIC2251-2YD5-TR; SOT95P280X100-5N
IC2: LM48580TL_NOPB; BGA12C50P3X4_146X196X68
J1: Power; PinHeader_1x02_P2.54mm_Vertical
J2: FC68131; CLIFF_FC68131
L1: LQH5BPN100MT0L; LQH5BPB100MT0L
L2: BRL3225T4R7M; INDC3225X170N
R1: 1M; R_0603_1608Metric
R2: 68k; R_0603_1608Metric
R3: 22k; R_0603_1608Metric
R4, R5: 10k; R_0603_1608Metric
R6: 10; R_0603_1608Metric
R7: 4,7; R_0603_1608Metric
TP1: Audio; TestPoint_Pad_D1.0mm
TP3: MEMS_POS_POLE; TestPoint_Pad_D1.0mm
TP4: MEMS_NEG_POLE; TestPoint_Pad_D1.0mm
TP5: VCC; TestPoint_Pad_D1.0mm
TP6: VBST; TestPoint_Pad_D1.0mm
TP7: +15V; TestPoint_Pad_D1.0mm
TP8: SW; TestPoint_Pad_D1.0mm
TP9, TP10: GND; TestPoint_Pad_D1.0mm
X1: Adap_UT_P2019

Connections:
+3V3: C1.1, C3.1, C4.1, IC1.4, IC1.5, IC2.B2, IC2.C2, IC2.C3, J1.2, L1.1, L2.1, TP5.1
+15V: C2.1, D1.1, R1.1, R4.2, R5.2, TP7.1
/AUDIO_IN: C10.1, J2.5, TP1.1
/MEMS_NEG_POLE: C8.1, R5.1, TP4.1, X1.2
/MEMS_POS_POLE: R6.2, TP3.1
GND: C1.2, C2.2, C3.2, C4.2, C5.2, C9.2, IC1.2, IC2.A2, IC2.D3, J1.1, J2.1, J2.2, R3.1, R7.1, TP9.1, TP10.1
unnamed: C5.1, D2.1, IC2.C1, IC2.D1, TP6.1
unnamed: C6.2, IC2.A3
unnamed: C7.1, R4.1, R6.1
unnamed: C7.2, IC2.A1
unnamed: C8.2, IC2.B1
unnamed: C9.1, IC2.B3
unnamed: C6.1, C10.2, R7.2
unnamed: D1.2, IC1.1, L1.2, TP8.1
unnamed: D2.2, IC2.D2, L2.2
unnamed: IC1.3, R1.2, R2.2
unnamed: R2.1, R3.2
